TiltMeSenpai/cubcon_dc27/hw/dc27_board.kicad_pcb

## KiCad design hw/dc27_board.kicad_pcb (2019-08-14)

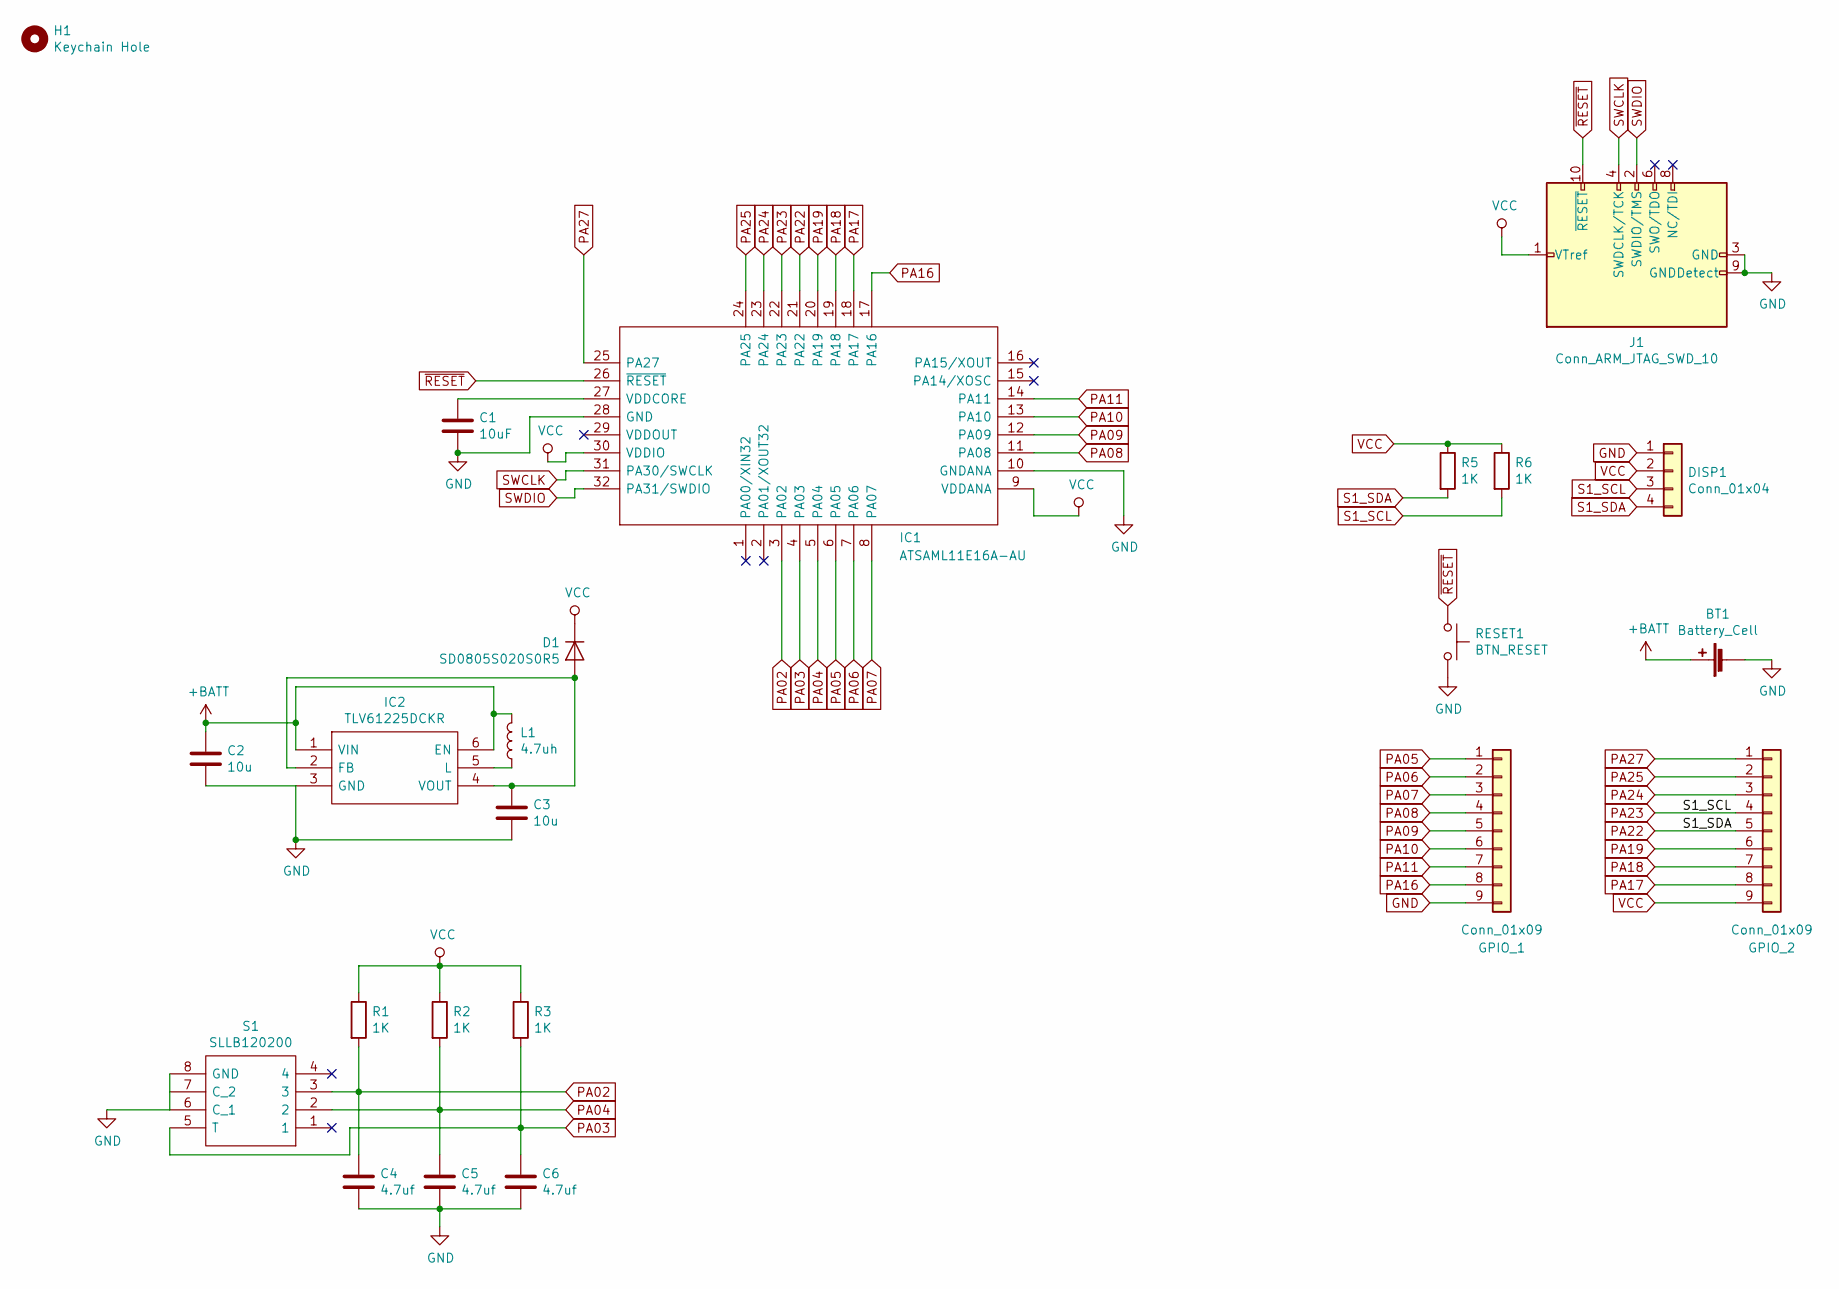
[picture p1: schematic dc27_board.sch]

Parts:
BT1: Battery_Cell; 2466; Mouser Part Number 534-2466
C1: 10uF; C_0805_2012Metric_Pad1.15x1.40mm_HandSolder
C2, C3: 10u; C_0805_2012Metric_Pad1.15x1.40mm_HandSolder; Mouser Part Number 80-C0805X106M9RAUTO
C4, C5, C6: 4.7uf; C_0805_2012Metric_Pad1.15x1.40mm_HandSolder
D1: SD0805S020S0R5; D_0805_2012Metric; Mouser Part Number 581-SD0805S020S0R5
DISP1: Conn_01x04; PinHeader_1x04_P2.54mm_Vertical
GPIO_1, GPIO_2: Conn_01x09; PinSocket_1x09_P2.54mm_Vertical
H1: Keychain Hole; MountingHole_2mm
IC1: ATSAML11E16A-AU; QFP80P900X900X120-32N; Mouser Part Number 579-ATSAML11E16A-AU
IC2: TLV61225DCKR; SOT65P210X110-6N; Mouser Part Number 595-TLV61225DCKR
J1: Conn_ARM_JTAG_SWD_10; PinHeader_2x05_P1.27mm_Vertical_SMD; Mouser Part Number 855-M50-3610542
L1: 4.7uh; L_0805_2012Metric_Pad1.15x1.40mm_HandSolder; Mouser Part Number 652-SRN2009T-4R7M
R1, R2, R3: 1K; C_0805_2012Metric_Pad1.15x1.40mm_HandSolder
R5, R6: 1K; R_0805_2012Metric_Pad1.15x1.40mm_HandSolder; Mouser Part Number 667-ERJ-UP6J102V
RESET1: BTN_RESET; SW_SPST_TL3342
S1: SLLB120200; Mouser Part Number 688-SLLB120200

Connections:
+BATT: BT1.1 (+), C2.1, IC2.1 (VIN), IC2.6 (EN), L1.2
GND: BT1.2 (-), C1.2, C2.2, C3.2, C4.2, C5.2, C6.2, DISP1.1, GPIO_1.9, IC1.10 (GNDANA), IC1.28 (GND), IC2.3 (GND), J1.3 (GND), J1.5 (GND), J1.9 (GNDDetect), RESET1.2, S1.6 (C_1), S1.8 (GND)
unnamed: C1.1, IC1.27 (VDDCORE)
unnamed: C3.1, D1.2 (A), IC2.2 (FB), IC2.4 (VOUT)
unnamed: IC2.5 (L), L1.1
PA02: C4.1, IC1.3 (PA02), R1.2, S1.3
PA03: C6.1, IC1.4 (PA03), R3.2, S1.5 (T)
PA04: C5.1, IC1.5 (PA04), R2.2, S1.2
PA05: GPIO_1.1, IC1.6 (PA05)
PA06: GPIO_1.2, IC1.7 (PA06)
PA07: GPIO_1.3, IC1.8 (PA07)
PA08: GPIO_1.4, IC1.11 (PA08)
PA09: GPIO_1.5, IC1.12 (PA09)
PA10: GPIO_1.6, IC1.13 (PA10)
PA11: GPIO_1.7, IC1.14 (PA11)
PA16: GPIO_1.8, IC1.17 (PA16)
PA17: GPIO_2.8, IC1.18 (PA17)
PA18: GPIO_2.7, IC1.19 (PA18)
PA19: GPIO_2.6, IC1.20 (PA19)
PA22: DISP1.4, GPIO_2.5, IC1.21 (PA22), R5.2
PA23: DISP1.3, GPIO_2.4, IC1.22 (PA23), R6.2
PA24: GPIO_2.3, IC1.23 (PA24)
PA25: GPIO_2.2, IC1.24 (PA25)
PA27: GPIO_2.1, IC1.25 (PA27)
SWCLK: IC1.31 (PA30/SWCLK), J1.4 (SWDCLK/TCK)
SWDIO: IC1.32 (PA31/SWDIO), J1.2 (SWDIO/TMS)
VCC: D1.1 (K), DISP1.2, GPIO_2.9, IC1.9 (VDDANA), IC1.30 (VDDIO), J1.1 (VTref), R1.1, R2.1, R3.1, R5.1, R6.1
~RESET: IC1.26 (~RESET), J1.10 (~RESET~), RESET1.1

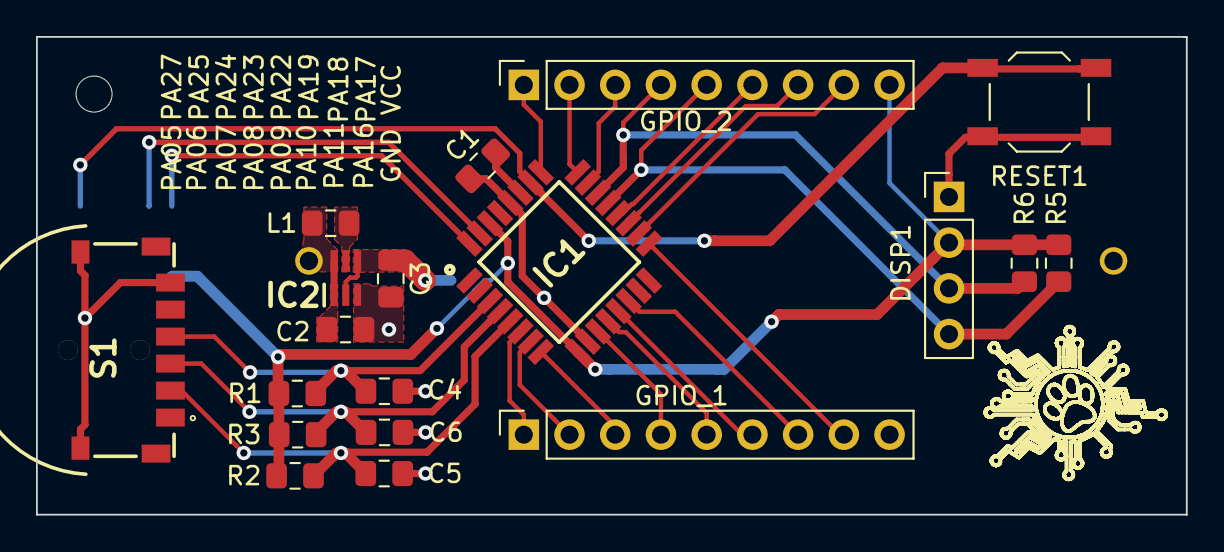
[picture p2: board dc27_board.kicad_pcb from above]

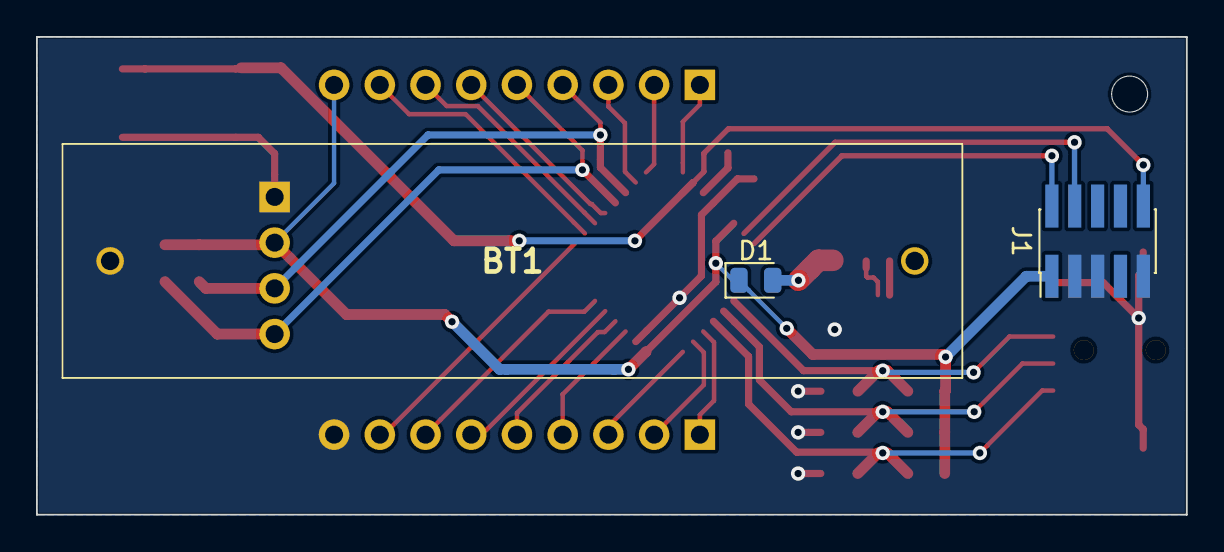
[picture p3: board dc27_board.kicad_pcb from below]

Board: 2 copper layers, 63.9 x 26.5 mm, 23 parts (3 on the bottom side), 28 nets.
