TiltMeSenpai/cubcon_dc27/fw/DC27 Board/driver_init.c

/*
 * Code generated from Atmel Start.
 *
 * This file will be overwritten when reconfiguring your Atmel Start project.
 * Please copy examples or other code you want to keep to a separate file
 * to avoid losing it when reconfiguring.
 */

#include "driver_init.h"
#include <peripheral_clk_config.h>
#include <utils.h>
#include <hal_init.h>

#if (defined(__ARM_FEATURE_CMSE) && (__ARM_FEATURE_CMSE != 3U))
/* Weak Non-secure callable function. Real one should be in secure gateway library. */
WEAK int32_t nsc_periph_clock_init(uint32_t gclk_id, uint32_t gclk_src)
{
	(void)gclk_id;
	(void)gclk_src;
	return 0;
}
#endif

struct timer_descriptor TIMER_0;

struct rand_sync_desc RAND_0;

struct i2c_m_sync_desc I2C_0;

void RAND_0_CLOCK_init(void)
{
	hri_mclk_set_APBCMASK_TRNG_bit(MCLK);
}

void RAND_0_init(void)
{
	RAND_0_CLOCK_init();
	rand_sync_init(&RAND_0, TRNG);
}

/**
 * \brief NVMCTRL initialization function
 *
 * Enables NVMCTRL peripheral, clocks and initializes driver
 */
void FLASH_0_clock_init(void)
{
#if (defined(__ARM_FEATURE_CMSE) && (__ARM_FEATURE_CMSE == 3U))
	hri_mclk_set_AHBMASK_NVMCTRL_bit(MCLK);
	hri_mclk_set_APBBMASK_NVMCTRL_bit(MCLK);
#endif
}

/**
 * \brief Timer initialization function
 *
 * Enables Timer peripheral, clocks and initializes Timer driver
 */
static void TIMER_0_init(void)
{
#if (defined(__ARM_FEATURE_CMSE) && (__ARM_FEATURE_CMSE == 3U))
	hri_mclk_set_APBCMASK_TC0_bit(MCLK);
	hri_gclk_write_PCHCTRL_reg(GCLK, TC0_GCLK_ID, CONF_GCLK_TC0_SRC | (1 << GCLK_PCHCTRL_CHEN_Pos));
#else
	nsc_periph_clock_init(TC0_GCLK_ID, CONF_GCLK_TC0_SRC);
#endif

	timer_init(&TIMER_0, TC0, _tc_get_timer());
}

void I2C_0_PORT_init(void)
{

	gpio_set_pin_pull_mode(PA22,
	                       // <y> Pull configuration
	                       // <id> pad_pull_config
	                       // <GPIO_PULL_OFF"> Off
	                       // <GPIO_PULL_UP"> Pull-up
	                       // <GPIO_PULL_DOWN"> Pull-down
	                       GPIO_PULL_OFF);

	gpio_set_pin_function(PA22, PINMUX_PA22C_SERCOM0_PAD0);

	gpio_set_pin_pull_mode(PA23,
	                       // <y> Pull configuration
	                       // <id> pad_pull_config
	                       // <GPIO_PULL_OFF"> Off
	                       // <GPIO_PULL_UP"> Pull-up
	                       // <GPIO_PULL_DOWN"> Pull-down
	                       GPIO_PULL_OFF);

	gpio_set_pin_function(PA23, PINMUX_PA23C_SERCOM0_PAD1);
}

void I2C_0_CLOCK_init(void)
{
#if (defined(__ARM_FEATURE_CMSE) && (__ARM_FEATURE_CMSE == 3U))
	hri_gclk_write_PCHCTRL_reg(GCLK, SERCOM0_GCLK_ID_CORE, CONF_GCLK_SERCOM0_CORE_SRC | (1 << GCLK_PCHCTRL_CHEN_Pos));
	hri_gclk_write_PCHCTRL_reg(GCLK, SERCOM0_GCLK_ID_SLOW, CONF_GCLK_SERCOM0_SLOW_SRC | (1 << GCLK_PCHCTRL_CHEN_Pos));
	hri_mclk_set_APBCMASK_SERCOM0_bit(MCLK);
#else
	nsc_periph_clock_init(SERCOM0_GCLK_ID_CORE, CONF_GCLK_SERCOM0_CORE_SRC);
	nsc_periph_clock_init(SERCOM0_GCLK_ID_SLOW, CONF_GCLK_SERCOM0_SLOW_SRC);
#endif
}

void I2C_0_init(void)
{
	I2C_0_CLOCK_init();
	i2c_m_sync_init(&I2C_0, SERCOM0);
	I2C_0_PORT_init();
}

void delay_driver_init(void)
{
	delay_init(SysTick);
}

void EXTERNAL_IRQ_0_init(void)
{
#if (defined(__ARM_FEATURE_CMSE) && (__ARM_FEATURE_CMSE == 3U))
	hri_gclk_write_PCHCTRL_reg(GCLK, EIC_GCLK_ID, CONF_GCLK_EIC_SRC | (1 << GCLK_PCHCTRL_CHEN_Pos));
	hri_mclk_set_APBAMASK_EIC_bit(MCLK);
#else
	nsc_periph_clock_init(EIC_GCLK_ID, CONF_GCLK_EIC_SRC);
#endif

	// Set pin direction to input
	gpio_set_pin_direction(PA02, GPIO_DIRECTION_IN);

	gpio_set_pin_pull_mode(PA02,
	                       // <y> Pull configuration
	                       // <id> pad_pull_config
	                       // <GPIO_PULL_OFF"> Off
	                       // <GPIO_PULL_UP"> Pull-up
	                       // <GPIO_PULL_DOWN"> Pull-down
	                       GPIO_PULL_OFF);

	gpio_set_pin_function(PA02, PINMUX_PA02A_EIC_EXTINT2);

	// Set pin direction to input
	gpio_set_pin_direction(PA03, GPIO_DIRECTION_IN);

	gpio_set_pin_pull_mode(PA03,
	                       // <y> Pull configuration
	                       // <id> pad_pull_config
	                       // <GPIO_PULL_OFF"> Off
	                       // <GPIO_PULL_UP"> Pull-up
	                       // <GPIO_PULL_DOWN"> Pull-down
	                       GPIO_PULL_OFF);

	gpio_set_pin_function(PA03, PINMUX_PA03A_EIC_EXTINT3);

	// Set pin direction to input
	gpio_set_pin_direction(PA04, GPIO_DIRECTION_IN);

	gpio_set_pin_pull_mode(PA04,
	                       // <y> Pull configuration
	                       // <id> pad_pull_config
	                       // <GPIO_PULL_OFF"> Off
	                       // <GPIO_PULL_UP"> Pull-up
	                       // <GPIO_PULL_DOWN"> Pull-down
	                       GPIO_PULL_OFF);

	gpio_set_pin_function(PA04, PINMUX_PA04A_EIC_EXTINT4);

	ext_irq_init();
}

void system_init(void)
{
#if (defined(__ARM_FEATURE_CMSE) && (__ARM_FEATURE_CMSE == 3U))
	/* Only initialize MCU clock when the project is TrustZone secure project  */
	init_mcu();
#endif

	// GPIO on PA05

	// Set pin direction to input
	gpio_set_pin_direction(PA05, GPIO_DIRECTION_IN);

	gpio_set_pin_pull_mode(PA05,
	                       // <y> Pull configuration
	                       // <id> pad_pull_config
	                       // <GPIO_PULL_OFF"> Off
	                       // <GPIO_PULL_UP"> Pull-up
	                       // <GPIO_PULL_DOWN"> Pull-down
	                       GPIO_PULL_DOWN);

	gpio_set_pin_function(PA05, GPIO_PIN_FUNCTION_OFF);

	// GPIO on PA06

	// Set pin direction to input
	gpio_set_pin_direction(PA06, GPIO_DIRECTION_IN);

	gpio_set_pin_pull_mode(PA06,
	                       // <y> Pull configuration
	                       // <id> pad_pull_config
	                       // <GPIO_PULL_OFF"> Off
	                       // <GPIO_PULL_UP"> Pull-up
	                       // <GPIO_PULL_DOWN"> Pull-down
	                       GPIO_PULL_DOWN);

	gpio_set_pin_function(PA06, GPIO_PIN_FUNCTION_OFF);

	// GPIO on PA07

	// Set pin direction to input
	gpio_set_pin_direction(PA07, GPIO_DIRECTION_IN);

	gpio_set_pin_pull_mode(PA07,
	                       // <y> Pull configuration
	                       // <id> pad_pull_config
	                       // <GPIO_PULL_OFF"> Off
	                       // <GPIO_PULL_UP"> Pull-up
	                       // <GPIO_PULL_DOWN"> Pull-down
	                       GPIO_PULL_DOWN);

	gpio_set_pin_function(PA07, GPIO_PIN_FUNCTION_OFF);

	// GPIO on PA08

	// Set pin direction to input
	gpio_set_pin_direction(PA08, GPIO_DIRECTION_IN);

	gpio_set_pin_pull_mode(PA08,
	                       // <y> Pull configuration
	                       // <id> pad_pull_config
	                       // <GPIO_PULL_OFF"> Off
	                       // <GPIO_PULL_UP"> Pull-up
	                       // <GPIO_PULL_DOWN"> Pull-down
	                       GPIO_PULL_DOWN);

	gpio_set_pin_function(PA08, GPIO_PIN_FUNCTION_OFF);

	// GPIO on PA09

	// Set pin direction to input
	gpio_set_pin_direction(PA09, GPIO_DIRECTION_IN);

	gpio_set_pin_pull_mode(PA09,
	                       // <y> Pull configuration
	                       // <id> pad_pull_config
	                       // <GPIO_PULL_OFF"> Off
	                       // <GPIO_PULL_UP"> Pull-up
	                       // <GPIO_PULL_DOWN"> Pull-down
	                       GPIO_PULL_DOWN);

	gpio_set_pin_function(PA09, GPIO_PIN_FUNCTION_OFF);

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

	// Set pin direction to output
	gpio_set_pin_direction(PA27, GPIO_DIRECTION_OUT);

	gpio_set_pin_function(PA27, GPIO_PIN_FUNCTION_OFF);

	RAND_0_init();

	FLASH_0_clock_init();
	FLASH_0_init();

	TIMER_0_init();

	I2C_0_init();

	delay_driver_init();
	EXTERNAL_IRQ_0_init();
}
