TiltMeSenpai/cubcon_dc27/(commit log)

2019-08-14 Release hw
    [dc27_board.kicad_pcb, dc27_board.sch]
2019-08-14 added bom files
    [hw_pass_manager.csv]
